RandomStudio/kineticPlatform/Ressources/Platformv2_2.pdf

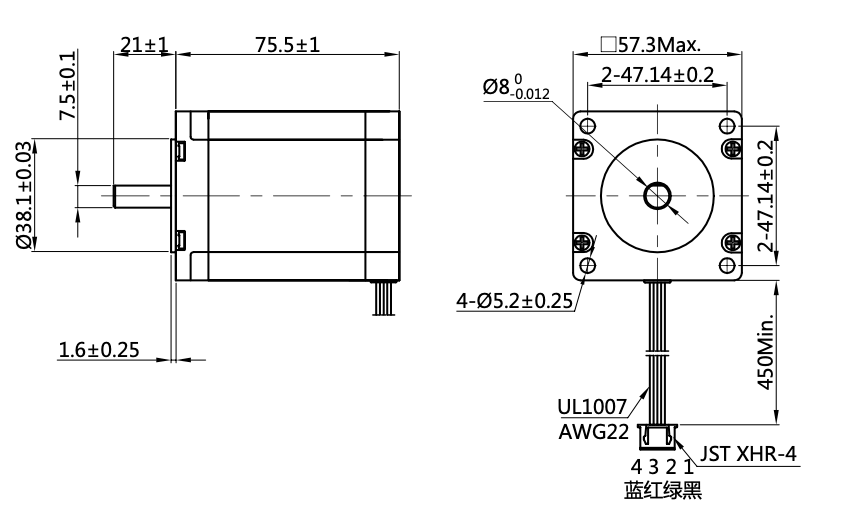
[picture p3: figure]

## Rotating Platform V1

LIVING LAB @ Random Studio Thomas Kaufmanas oct 24'

Ball Bearings:

Stepper:

GR = 120/20 = 6
500/6,5 ≈ 83RPM (max)
in

20T

out

220T

All measurements in mm
Drawing to size

Gear Ratio:
GR = Øout / Øin
RPMout = RPMin / GR
RPMin = 500 max ???

GR = 150/30 = 5
500/5 = 100RPM (max)

GR = 100/30 = 3,3
500/5 = 150RPM (max)

in

in

30mm

30mm

out

out

150mm

100mm

GR = 200/30 = 6,67
500/6,67 ≈ 75RPM (max)

in

30mm

out

200mm
