RandomStudio/kineticPlatform/Ressources/1.png

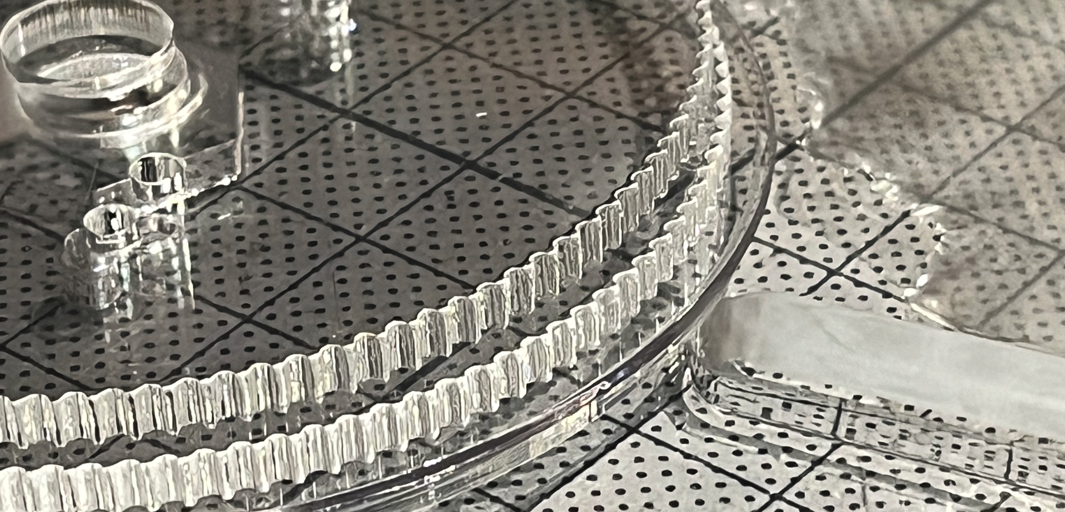
Ressources/1.png
