RandomStudio/kineticPlatform/Ressources/3.png

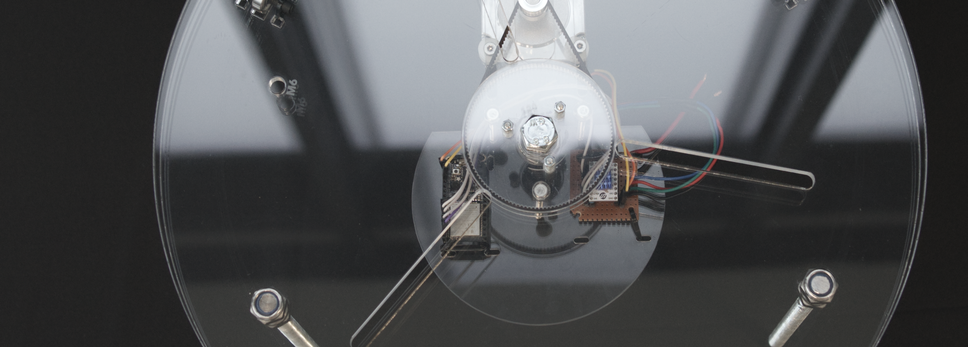
Ressources/3.png
