RandomStudio/kineticPlatform/Ressources/Spatial LLM Demo at FF.png

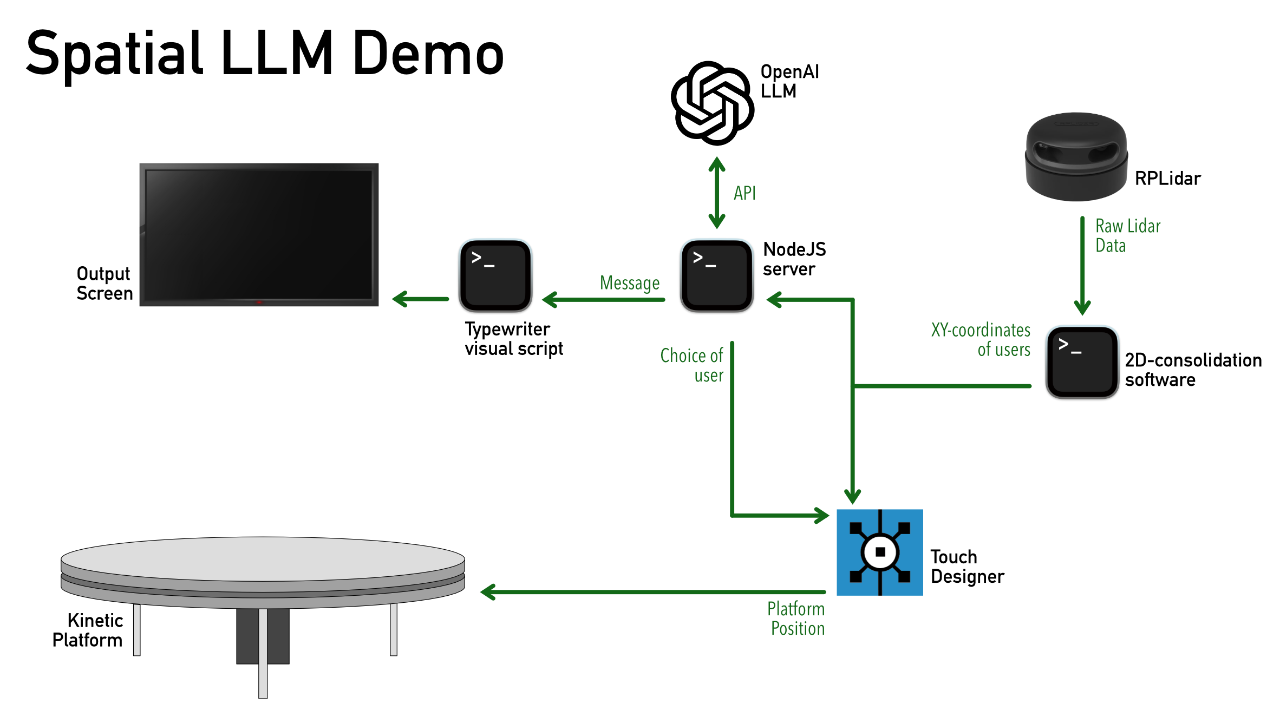
Ressources/Spatial LLM Demo at FF.png
