RandomStudio/kineticPlatform/Ressources/Wiring Arduino.pdf

# Kinetic Platform v2 Wiring

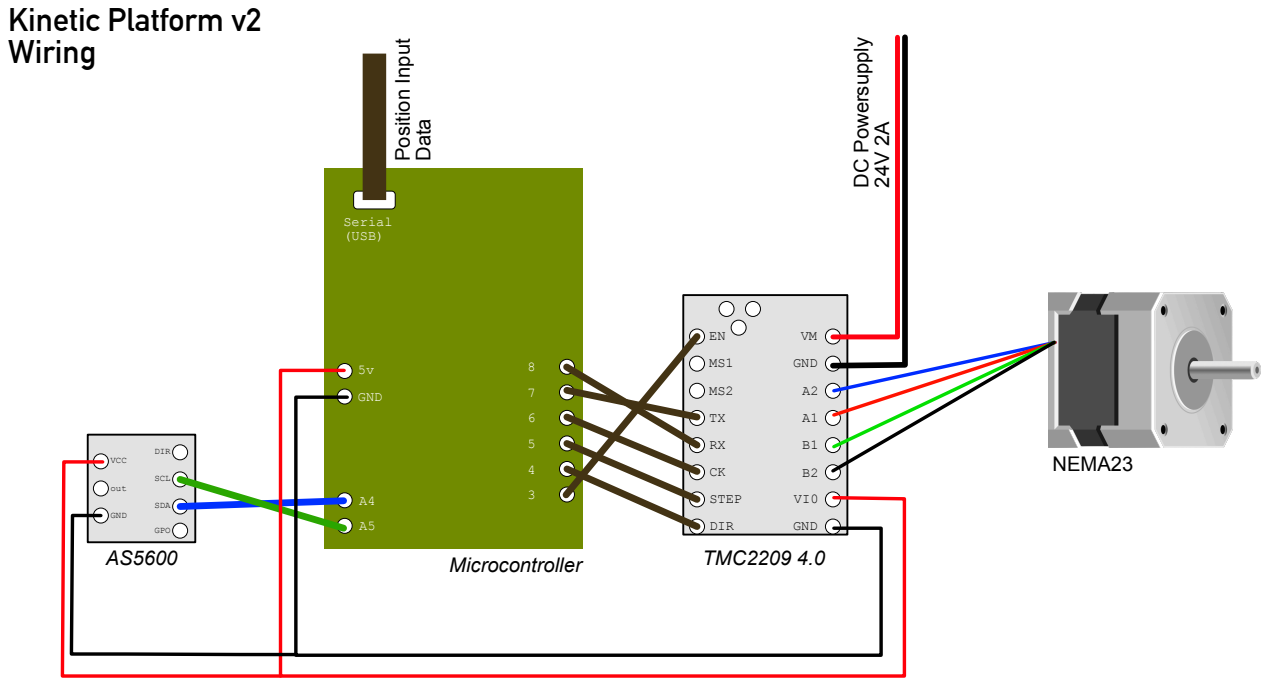
[picture p7: page 1]
TMC2209 4.0; DC Powersupply; Position Input; Data; Microcontroller AS5600; NEMA23; DIR; GND; Serial (USB); STEP; out; SCL; SDA; GPO; VCC
