RandomStudio/kineticPlatform/Ressources/PlatformV2.pdf

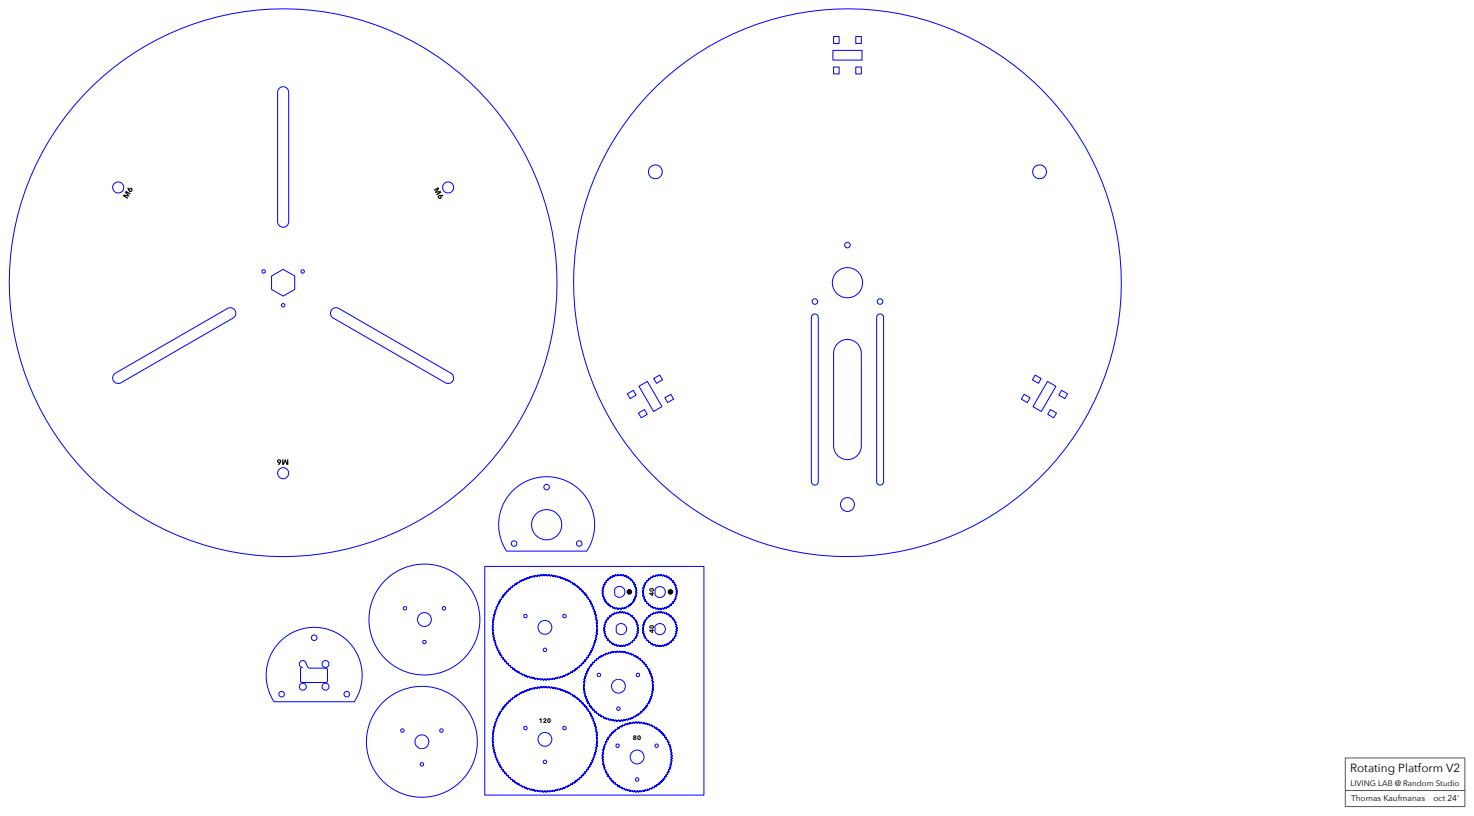
[picture p8: page 1]

Rotating Platform V2
LIVING LAB @ Random Studio
Thomas Kaufmanas oct 24'
