RandomStudio/kineticPlatform/kineticPlatform/Software/TMC5160_Acceleration_Profile/TMC5160_Acceleration_Profile.ino

/*
  Bare Minimum example for accelerating rotation platform using TMC5160 driver.
  Thomas Kaufmanas | Random Studio | 2024

*/


#include <TMCStepper.h>

#define EN_PIN    7 //enable
#define DIR_PIN   8 //direction
#define STEP_PIN  9 //step
#define CS_PIN   10 //CS
#define MOSI_PIN 11 //SDI/MOSI
#define MISO_PIN 12 //SDO/MISO
#define SCK_PIN  13 //CLK/SCK 

#define R_SENSE   0.075f //Respective to QHV5160 TMC5160 module

TMC5160Stepper tmc = TMC5160Stepper(CS_PIN, R_SENSE);

int stepSpeed = 20;
long timer1 = 0;
long timer2 = 0;

int accDir = 0; //0 = down, 1 = up

void setup()
{
  pinMode(EN_PIN, OUTPUT);
  pinMode(DIR_PIN, OUTPUT);
  pinMode(STEP_PIN, OUTPUT);
  digitalWrite(EN_PIN, HIGH); //deactivate driver for now...
  digitalWrite(DIR_PIN, LOW);
  digitalWrite(STEP_PIN, LOW);

  //SPI setup on hardware pins: 10, 11, 12, 13
  pinMode(SS, OUTPUT);
  pinMode(MOSI, OUTPUT);
  pinMode(MISO, INPUT);
  pinMode(SCK, OUTPUT);
  digitalWrite(SS, HIGH);
  digitalWrite(MOSI, LOW);
  digitalWrite(MISO, HIGH);
  digitalWrite(SCK, LOW);

  Serial.begin(9600); //init serial port and set baudrate
  Serial.println("\nRestart ");

  tmc.begin();
  tmc.toff(4);
  tmc.blank_time(24);
  tmc.en_pwm_mode(true); //Enable StealthChop (quiet driving)
  tmc.pwm_autoscale(true); //Some say this is needed?
  tmc.microsteps(0);  //0 for full step. 2,4,8,16 etc.
  tmc.rms_current(2000); //Motor runs 2.8A peak ≈ keep it round 2 for good measure.

  digitalWrite(EN_PIN, LOW); //Enable motor
}



void loop() {
  // Run diagnostics every second
  if ((millis() - timer1) > 1000) {
    diagnostics();
    timer1 = millis();
  }


  if (millis() - timer2 > 1000) {
    if (!accDir) {
      stepSpeed -= 1;
    }
    else {
      stepSpeed += 1;
    }

    if (stepSpeed > 20) { //Min speed
      accDir = 0;
    }
    if (stepSpeed < 5) { //Max speed
      accDir = 1;
    }

    //Serial.println(speed1);

    timer2 = millis();
  }



  digitalWrite(STEP_PIN, HIGH);
  delayMicroseconds(1);
  digitalWrite(STEP_PIN, LOW);
  delay(stepSpeed);


} //End of void




void diagnostics() {
  if (tmc.diag0_error()) {
    Serial.println(F("DIAG0 error"));
  }
  if (tmc.ot())         {
    Serial.println(F("Overtemp."));
  }
  if (tmc.otpw())       {
    Serial.println(F("Overtemp. PW"));
  }
  if (tmc.s2ga())       {
    Serial.println(F("Short to Gnd A"));
  }
  if (tmc.s2gb())       {
    Serial.println(F("Short to Gnd B"));
  }
  if (tmc.ola())        {
    Serial.println(F("Open Load A"));
  }
  if (tmc.olb())        {
    Serial.println(F("Open Load B"));
  }
}
