RandomStudio/kineticPlatform/(commit log)

2024-10-15 Updated blocking issue from parseint
    [TMC2208_Rotate_to_angle_serial.ino]
2024-10-21 Raw visualisation + fix virtual platform pos
    [TMC2208_Rotate_to_angle_serial.ino]
2024-11-06 Shortest path + tolerance
    [TMC2208_Rotate_to_angle.ino]
2024-11-19 Update Arduino sketch + new TD file
